dragonmux/HeadphoneAmp/hardware/HeadphoneAmp/HeadphoneAmp.kicad_pcb

## KiCad design hardware/HeadphoneAmp/HeadphoneAmp.kicad_pcb (2022-03-04)

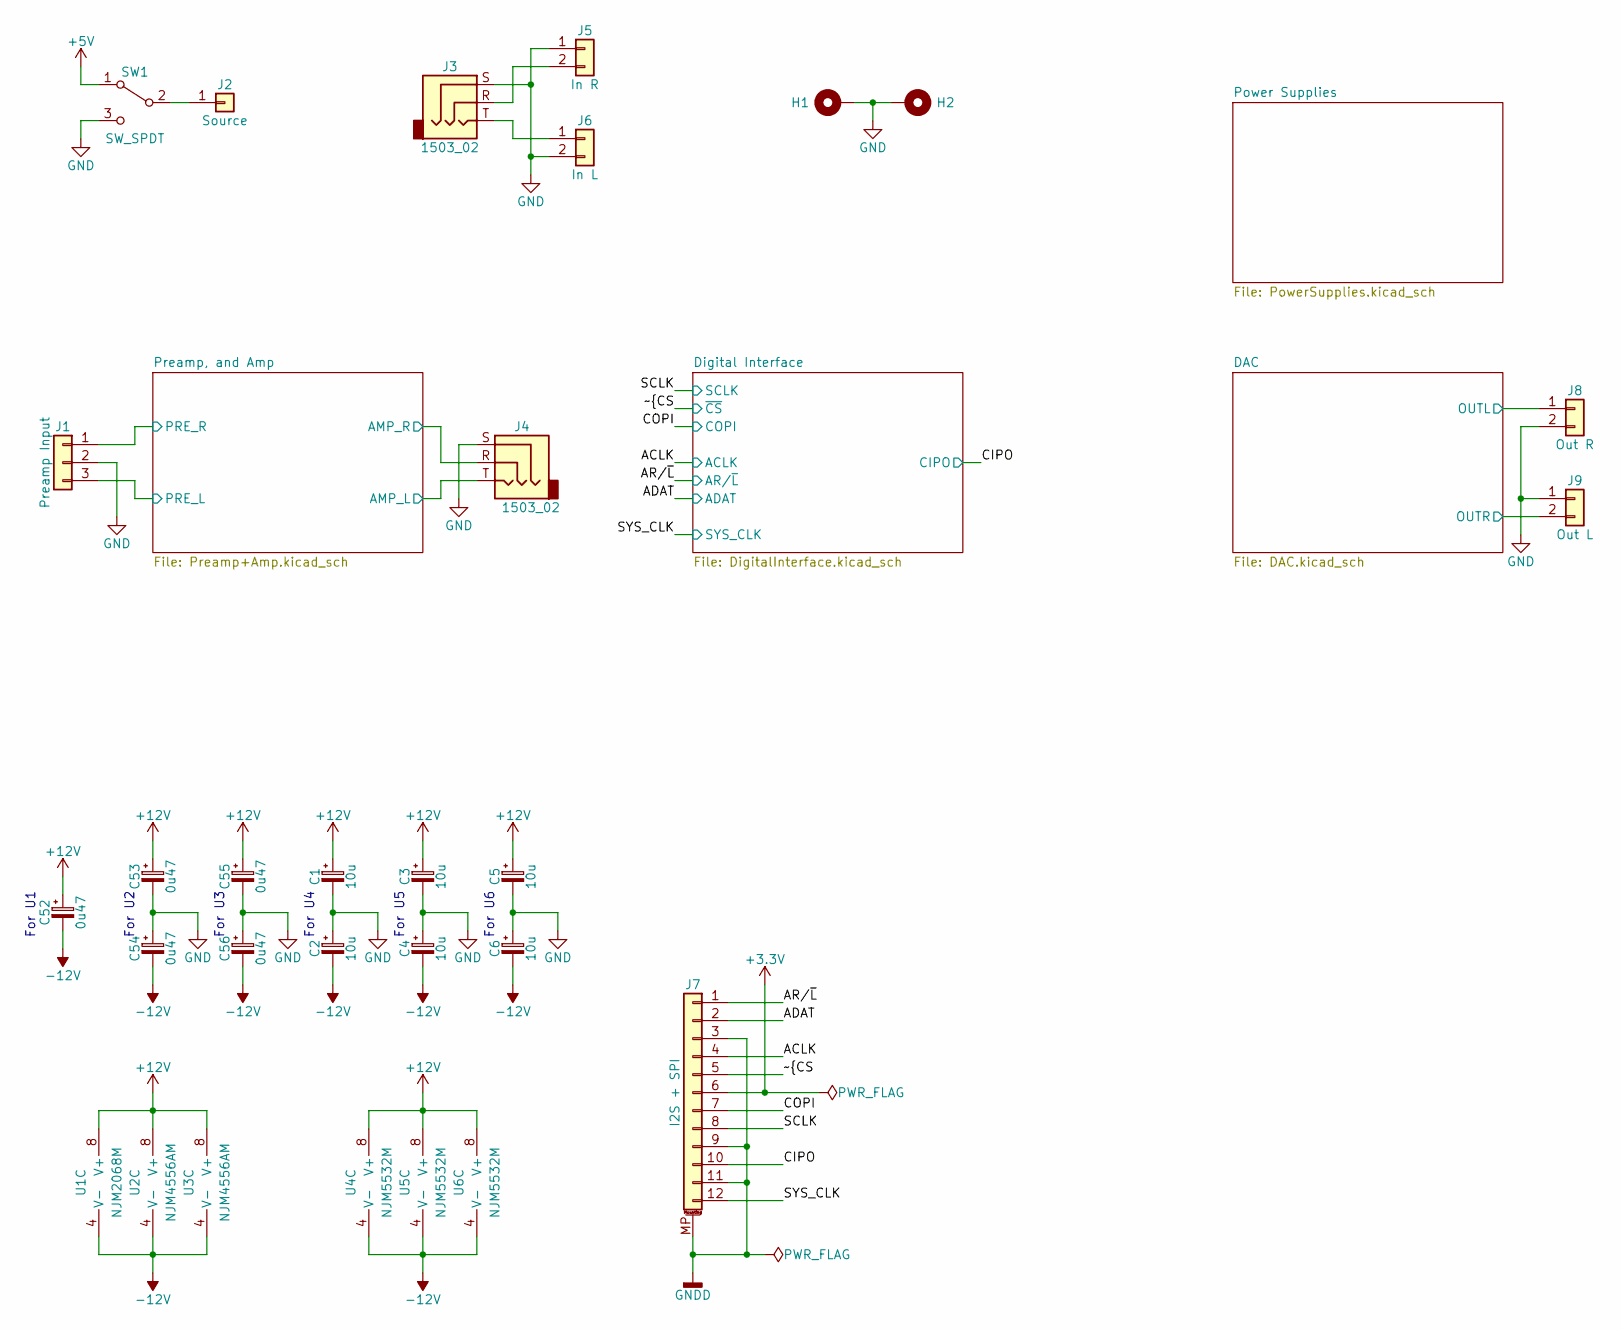
[picture p1: schematic HeadphoneAmp.kicad_sch, Headphone Amplifier + 24-bit -120dBm DAC]

Parts:
C1, C2, C3, C4, C5, C6: 10u; CP_EIA-3216-18_A; MPN 293D106X0016A2TE3
C52, C53, C54, C55, C56: 0u47; CP_EIA-3216-18_A; MPN F931V474KAA
H1, H2: MountingHole_Pad; MountingHole_3.2mm_M3_Pad
J1: Preamp Input; PinHeader_1x03_P2.54mm_Vertical
J2: Source; PinHeader_1x01_P2.54mm_Vertical
J3, J4: 1503_02; 1503-02; MPN 1503 02
J5: In R; PinHeader_1x02_P2.54mm_Vertical
J6: In L; PinHeader_1x02_P2.54mm_Vertical
J7: I2S + SPI; 1-17345952-2_1x12-1MP_P0.5mm_Horizontal; MPN 1-1734592-2
J8: Out R; PinHeader_1x02_P2.54mm_Vertical
J9: Out L; PinHeader_1x02_P2.54mm_Vertical
SW1: SW_SPDT; PN1x-30EQ; MPN PN12SHNA03QE
U1: NJM2068M; SO-8_5.3x5.3mm_P1.27mm; MPN NJM2068M
U2, U3: NJM4556AM; SO-8_5.3x5.3mm_P1.27mm; MPN NJM4556AM
U4, U5, U6: NJM5532M; SO-8_5.3x5.3mm_P1.27mm; MPN NJM5532M

Connections:
+3V3: J7.6; also elsewhere on the board
+5V: SW1.1 (A); also elsewhere on the board
+12V: C1.1, C3.1, C5.1, C52.1, C53.1, C55.1, U1.8 (V+), U2.8 (V+), U3.8 (V+), U4.8 (V+), U5.8 (V+), U6.8 (V+); also elsewhere on the board
-12V: C2.2, C4.2, C6.2, C52.2, C54.2, C56.2, U1.4 (V-), U2.4 (V-), U3.4 (V-), U4.4 (V-), U5.4 (V-), U6.4 (V-); also elsewhere on the board
/ACLK: J7.4; also elsewhere on the board
/ADAT: J7.2; also elsewhere on the board
/AR/~L: J7.1; also elsewhere on the board
/CIPO: J7.10; also elsewhere on the board
/COPI: J7.7; also elsewhere on the board
/DAC/OUTL: J8.1; also elsewhere on the board
/DAC/OUTR: J9.2; also elsewhere on the board
/Preamp, and Amp/AMP_L: J4.T; also elsewhere on the board
/Preamp, and Amp/AMP_R: J4.R; also elsewhere on the board
/Preamp, and Amp/PRE_L: J1.3; also elsewhere on the board
/Preamp, and Amp/PRE_R: J1.1; also elsewhere on the board
/SCLK: J7.8; also elsewhere on the board
/SYS_CLK: J7.12; also elsewhere on the board
/~CS: J7.5; also elsewhere on the board
GND: C1.2, C2.1, C3.2, C4.1, C5.2, C6.1, C53.2, C54.1, C55.2, C56.1, H1.1, H2.1, J1.2, J3.S, J4.S, J5.1, J6.2, J8.2, J9.1, SW1.3 (C); also elsewhere on the board
GNDD: J7.3, J7.9, J7.11, J7.MP (MountPin); also elsewhere on the board
unnamed: J2.1, SW1.2 (B)
unnamed: J3.R, J5.2
unnamed: J3.T, J6.1

Notes on the sheet:
For U4
For U6
For U3
For U1
For U5
For U2

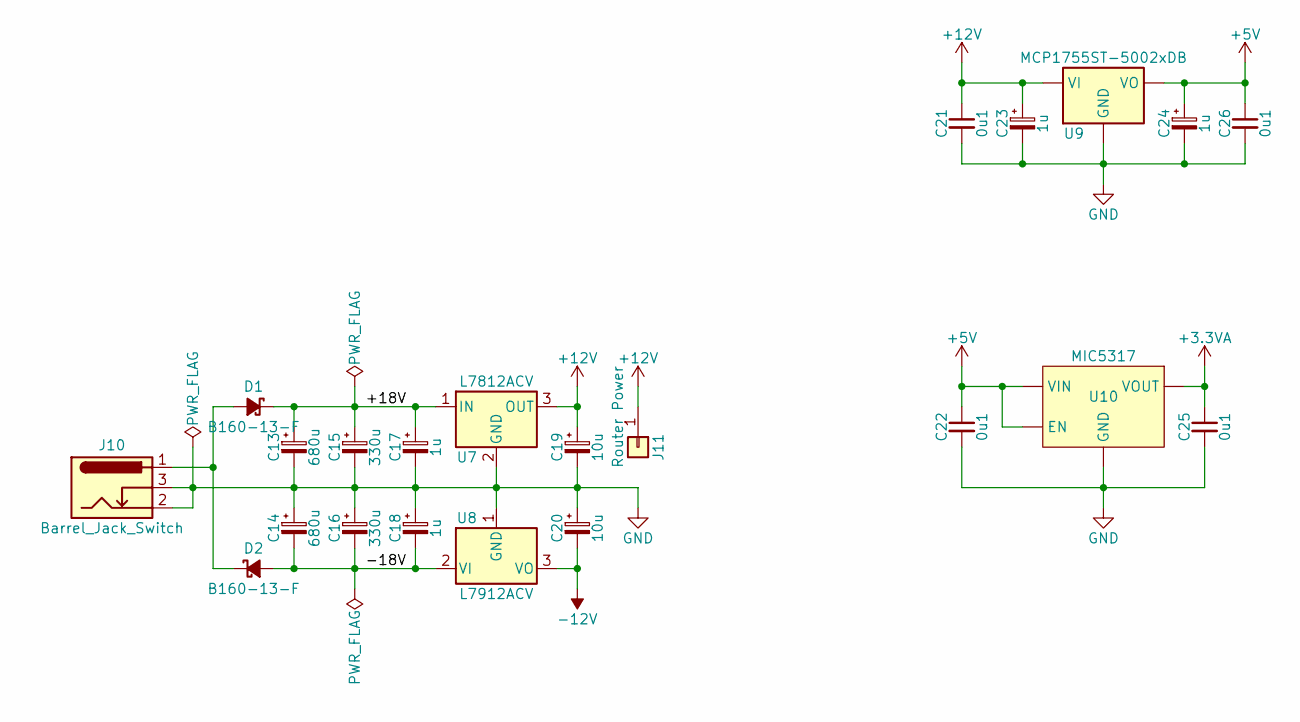
[picture p2: schematic PowerSupplies.kicad_sch, Headphone Amplifier + 24-bit -120dBm DAC]

Parts:
C13, C14: 680u; CP_Radial_D10.0mm_P5.00mm; MPN 25PX680MEFC10X12.5
C15, C16: 330u; CP_Radial_D8.0mm_P3.50mm; MPN 25PX330MEFC8X11.5
C17, C18: 1u; CP_EIA-3216-18_A; MPN 293D105X9025A2TE3
C19, C20: 10u; CP_EIA-3216-18_A; MPN 293D106X0016A2TE3
C21, C22, C26: 0u1; C1210; MPN ECH-U1C104GX5
C23, C24: 1u; CP_EIA-3216-18_A; MPN 293D105X9016A2TE3
C25: 0u1; C0603; MPN CGA3E2X7R1E104K080AA
D1, D2: B160-13-F; D_SMA; MPN B160-13-F
J10: Barrel_Jack_Switch; BarrelJack_GCT_DCJ200-10-A_Horizontal; MPN DCJ200-10-A-K1-K
J11: Router Power; PinHeader_1x01_P2.54mm_Vertical
U7: L7812ACV; TO-220-3_Vertical; MPN L7812ACV
U8: L7912ACV; TO-220-3_Vertical; MPN L7912ACV
U9: MCP1755ST-5002xDB; SOT-223; MPN MCP1755ST-5002E/DB
U10: MIC5317; SOT-23-5; MPN MIC5317-3.3YM5-TR

Connections:
+3.3VA: C25.1, U10.5 (VOUT); also elsewhere on the board
+5V: C22.1, C24.1, C26.1, U9.3 (VO), U10.1 (VIN), U10.3 (EN); also elsewhere on the board
+12V: C19.1, C21.1, C23.1, J11.1, U7.3 (OUT), U9.1 (VI); also elsewhere on the board
-12V: C20.2, U8.3 (VO); also elsewhere on the board
/Power Supplies/+18V: C13.1, C15.1, C17.1, D1.1 (K), U7.1 (IN)
/Power Supplies/-18V: C14.2, C16.2, C18.2, D2.2 (A), U8.2 (VI)
GND: C13.2, C14.1, C15.2, C16.1, C17.2, C18.1, C19.2, C20.1, C21.2, C22.2, C23.2, C24.2, C25.2, C26.2, J10.2, J10.3, U7.2 (GND), U8.1 (GND), U9.2 (GND), U10.2 (GND); also elsewhere on the board
unnamed: D1.2 (A), D2.1 (K), J10.1

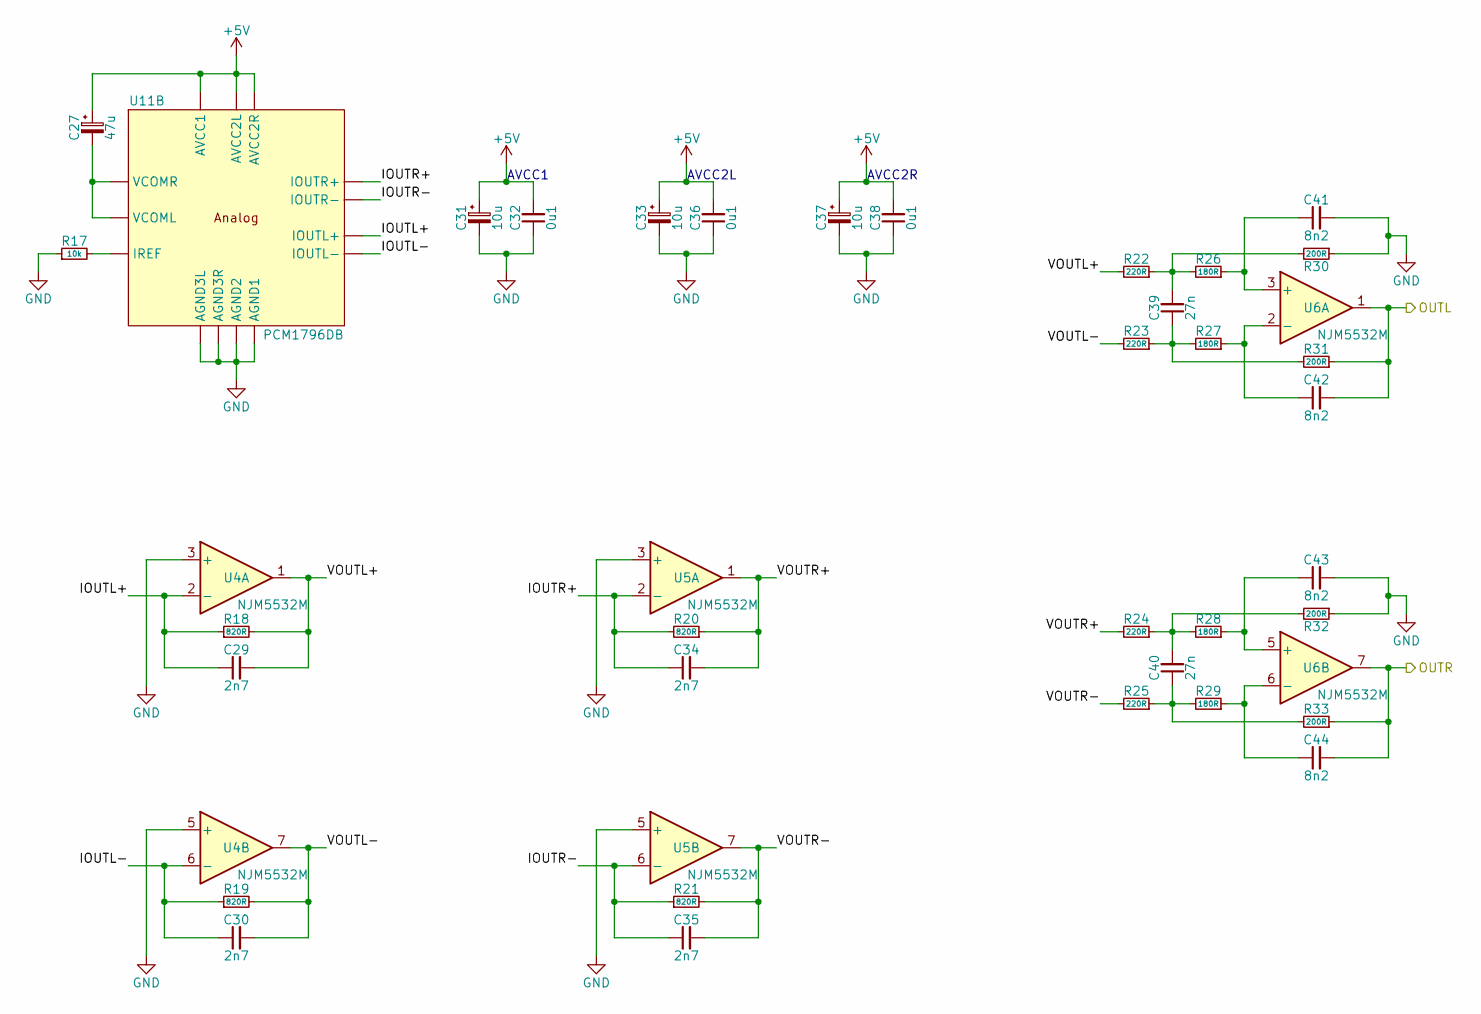
[picture p3: schematic DAC.kicad_sch, Headphone Amplifier + 24-bit -120dBm DAC]

Parts:
C27: 47u; CP_EIA-3528-21_B; MPN 293D476X9010B2TE3
C29, C30, C34, C35: 2n7; C0603; MPN ECH-U1C272GX5
C31, C33, C37: 10u; CP_EIA-3216-18_A; MPN 293D106X0016A2TE3
C32, C36, C38: 0u1; C1210; MPN ECH-U1C104GX5
C39, C40: 27n; C1206; MPN ECH-U1C273GX5
C41, C42, C43, C44: 8n2; C0805; MPN ECH-U1C822GX5
R17: 10k; R0603; MPN RN73H1JTTD1002B25
R18, R19, R20, R21: 820R; R0603; MPN RN73H1JTTD8200F100
R22, R23, R24, R25: 220R; R0603; MPN RN73H1JTTD2200F100
R26, R27, R28, R29: 180R; R0603; MPN RN73H1JTTD1800F100
R30, R31, R32, R33: 200R; R0603; MPN RN73H1JTTD2000B25
U4, U5, U6: NJM5532M; SO-8_5.3x5.3mm_P1.27mm; MPN NJM5532M
U11: PCM1796DB; SSOP-28_5.3x10.2mm_P0.65mm; MPN PCM1796DB

Connections:
+5V: C27.1, C31.1, C32.2, C33.1, C36.2, C37.1, C38.2, U11.15 (AVCC2R), U11.23 (AVCC1), U11.28 (AVCC2L); also elsewhere on the board
/DAC/IOUTL+: C29.1, R18.1, U4.2 (-), U11.25 (IOUTL+)
/DAC/IOUTL-: C30.1, R19.1, U4.6 (-), U11.26 (IOUTL-)
/DAC/IOUTR+: C34.1, R20.2, U5.2 (-), U11.17 (IOUTR+)
/DAC/IOUTR-: C35.1, R21.1, U5.6 (-), U11.18 (IOUTR-)
/DAC/OUTL: C42.2, R31.1, U6.1; also elsewhere on the board
/DAC/OUTR: C44.2, R33.1, U6.7; also elsewhere on the board
/DAC/VOUTL+: C29.2, R18.2, R22.2, U4.1
/DAC/VOUTL-: C30.2, R19.2, R23.2, U4.7
/DAC/VOUTR+: C34.2, R20.1, R24.2, U5.1
/DAC/VOUTR-: C35.2, R21.2, R25.2, U5.7
GND: C31.2, C32.1, C33.2, C36.1, C37.2, C38.1, C41.2, C43.2, R17.1, R30.1, R32.1, U4.3 (+), U4.5 (+), U5.3 (+), U5.5 (+), U11.16 (AGND3R), U11.19 (AGND1), U11.24 (AGND2), U11.27 (AGND3L); also elsewhere on the board
unnamed: C27.2, U11.21 (VCOMR), U11.22 (VCOML)
unnamed: C39.1, R23.1, R27.2, R31.2
unnamed: C39.2, R22.1, R26.2, R30.2
unnamed: C40.1, R25.1, R29.2, R33.2
unnamed: C40.2, R24.1, R28.2, R32.2
unnamed: C41.1, R26.1, U6.3 (+)
unnamed: C42.1, R27.1, U6.2 (-)
unnamed: C43.1, R28.1, U6.5 (+)
unnamed: C44.1, R29.1, U6.6 (-)
unnamed: R17.2, U11.20 (IREF)

Notes on the sheet:
AVCC2R
AVCC1
AVCC2L

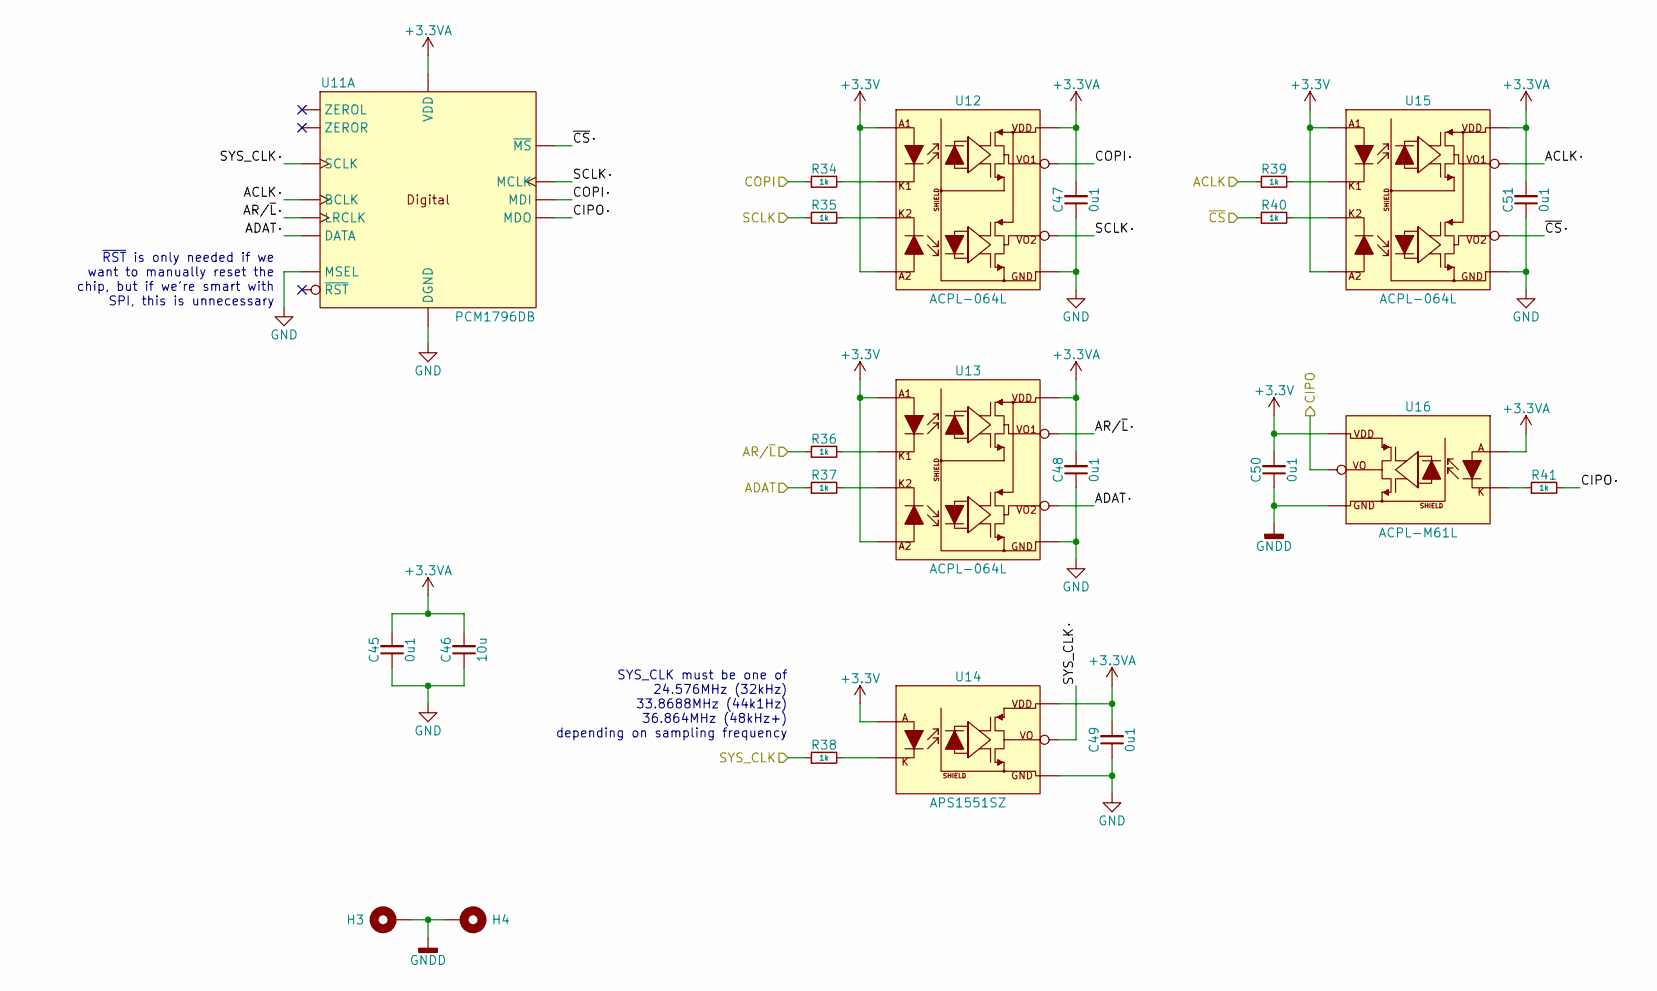
[picture p4: schematic DigitalInterface.kicad_sch]

Parts:
C45, C47, C48, C49, C50, C51: 0u1; C0603; MPN CGA3E2X7R1E104K080AA
C46: 10u; C0805; MPN GRM21BR61E106KA73L
H3, H4: MountingHole_Pad; MountingHole_3.2mm_M3_Pad
R34, R35, R36, R37, R38, R39, R40, R41: 1k; R0603; MPN CRCW06031K00FKEA
U11: PCM1796DB; SSOP-28_5.3x10.2mm_P0.65mm; MPN PCM1796DB
U12, U13, U15: ACPL-064L; SO-8_3.9x4.9mm_P1.27mm; MPN ACPL-064L-500E
U14: APS1551SZ; SO-5_4.4x4.3mm_P1.27mm; MPN APS1551SZ
U16: ACPL-M61L; SO-5_4.4x3.6mm_P1.27mm; MPN ACPL-M61L-5x0E

Connections:
+3.3VA: C45.2, C46.2, C47.2, C48.2, C49.2, C51.2, U11.9 (VDD), U12.8 (VDD), U13.8 (VDD), U14.6 (VDD), U15.8 (VDD), U16.1 (A); also elsewhere on the board
+3V3: C50.2, U12.1 (A1), U12.4 (A2), U13.1 (A1), U13.4 (A2), U14.1 (A), U15.1 (A1), U15.4 (A2), U16.6 (VDD); also elsewhere on the board
/ACLK: R39.1; also elsewhere on the board
/ADAT: R37.1; also elsewhere on the board
/AR/~L: R36.1; also elsewhere on the board
/CIPO: U16.5 (VO); also elsewhere on the board
/COPI: R34.1; also elsewhere on the board
/Digital Interface/ACLK·: U11.6 (BCLK), U15.7 (VO1)
/Digital Interface/ADAT·: U11.5 (DATA), U13.6 (VO2)
/Digital Interface/AR/~L·: U11.4 (LRCLK), U13.7 (VO1)
/Digital Interface/CIPO·: R41.2, U11.13 (MDO)
/Digital Interface/COPI·: U11.11 (MDI), U12.7 (VO1)
/Digital Interface/SCLK·: U11.12 (MCLK), U12.6 (VO2)
/Digital Interface/SYS_CLK·: U11.7 (SCLK), U14.5 (VO)
/Digital Interface/~CS·: U11.10 (~MS), U15.6 (VO2)
/SCLK: R35.1; also elsewhere on the board
/SYS_CLK: R38.1; also elsewhere on the board
/~CS: R40.1; also elsewhere on the board
GND: C45.1, C46.1, C47.1, C48.1, C49.1, C51.1, U11.3 (MSEL), U11.8 (DGND), U12.5 (GND), U13.5 (GND), U14.4 (GND), U15.5 (GND); also elsewhere on the board
GNDD: C50.1, H3.1, H4.1, U16.4 (GND); also elsewhere on the board
unnamed: R34.2, U12.2 (K1)
unnamed: R35.2, U12.3 (K2)
unnamed: R36.2, U13.2 (K1)
unnamed: R37.2, U13.3 (K2)
unnamed: R38.2, U14.3 (K)
unnamed: R39.2, U15.2 (K1)
unnamed: R40.2, U15.3 (K2)
unnamed: R41.1, U16.3 (K)

Notes on the sheet:
SYS_CLK must be one of 24.576MHz (32kHz) 33.8688MHz (44k1Hz) 36.864MHz (48kHz+) depending on sampling frequency
~{RST} is only needed if we want to manually reset the chip, but if we're smart with SPI, this is unnecessary

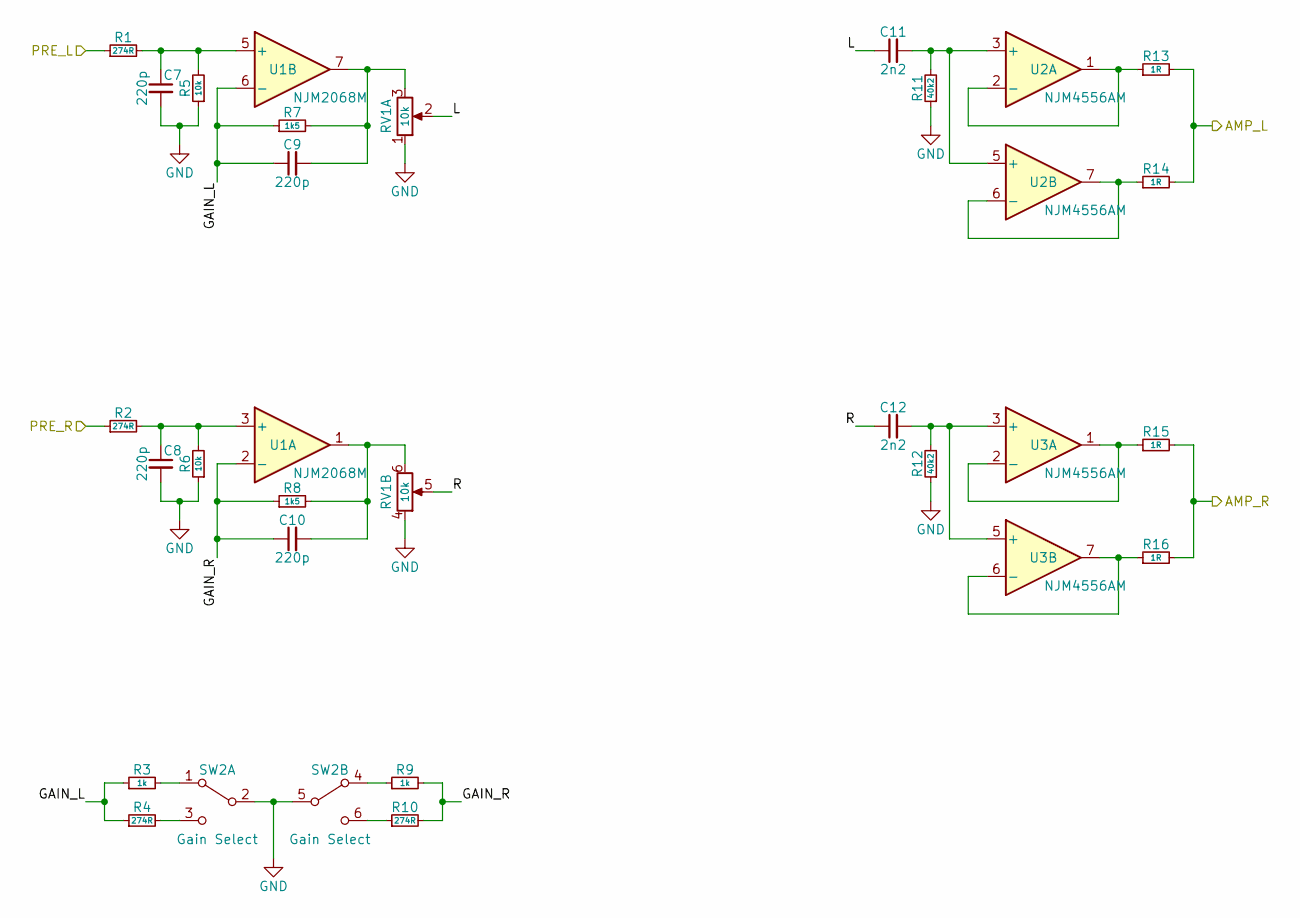
[picture p5: schematic Preamp+Amp.kicad_sch, Headphone Amplifier + 24-bit -120dBm DAC]

Parts:
C7, C8, C9, C10: 220p; C0603; MPN ECH-U1C221GX5
C11, C12: 2n2; C0603; MPN ECH-U1C222GX5
R1, R2, R4, R10: 274R; R0603; MPN RN731JTTD2740B25
R3, R9: 1k; R0603; MPN RN73H1JTTD1001D25
R5, R6: 10k; R0603; MPN RN73H1JTTD1002B25
R7, R8: 1k5; R0603; MPN RN73H1JTTD1501B25
R11, R12: 40k2; R0603; MPN RN73H1ETTP4022F25
R13, R14, R15, R16: 1R; R1206; MPN MCA12060C1008FP500
RV1: 10k; PTD902; MPN PTD902-2015F-A103
SW2: Gain Select; PN2x-30EQ; MPN PN22LENA03QE
U1: NJM2068M; SO-8_5.3x5.3mm_P1.27mm; MPN NJM2068M
U2, U3: NJM4556AM; SO-8_5.3x5.3mm_P1.27mm; MPN NJM4556AM

Connections:
/Preamp, and Amp/AMP_L: R13.2, R14.2; also elsewhere on the board
/Preamp, and Amp/AMP_R: R15.2, R16.2; also elsewhere on the board
/Preamp, and Amp/GAIN_L: C9.1, R3.1, R4.1, R7.1, U1.6 (-)
/Preamp, and Amp/GAIN_R: C10.1, R8.1, R9.2, R10.2, U1.2 (-)
/Preamp, and Amp/L: C11.1, RV1.2
/Preamp, and Amp/PRE_L: R1.1; also elsewhere on the board
/Preamp, and Amp/PRE_R: R2.1; also elsewhere on the board
/Preamp, and Amp/R: C12.1, RV1.5
GND: C7.2, C8.2, R5.1, R6.1, R11.1, R12.1, RV1.1, RV1.4, SW2.2 (B), SW2.5 (B); also elsewhere on the board
unnamed: C7.1, R1.2, R5.2, U1.5 (+)
unnamed: C8.1, R2.2, R6.2, U1.3 (+)
unnamed: C9.2, R7.2, RV1.3, U1.7
unnamed: C10.2, R8.2, RV1.6, U1.1
unnamed: C11.2, R11.2, U2.3 (+), U2.5 (+)
unnamed: C12.2, R12.2, U3.3 (+), U3.5 (+)
unnamed: R3.2, SW2.1 (A)
unnamed: R4.2, SW2.3 (C)
unnamed: R9.1, SW2.4 (A)
unnamed: R10.1, SW2.6 (C)
unnamed: R13.1, U2.1, U2.2 (-)
unnamed: R14.1, U2.6 (-), U2.7
unnamed: R15.1, U3.1, U3.2 (-)
unnamed: R16.1, U3.6 (-), U3.7

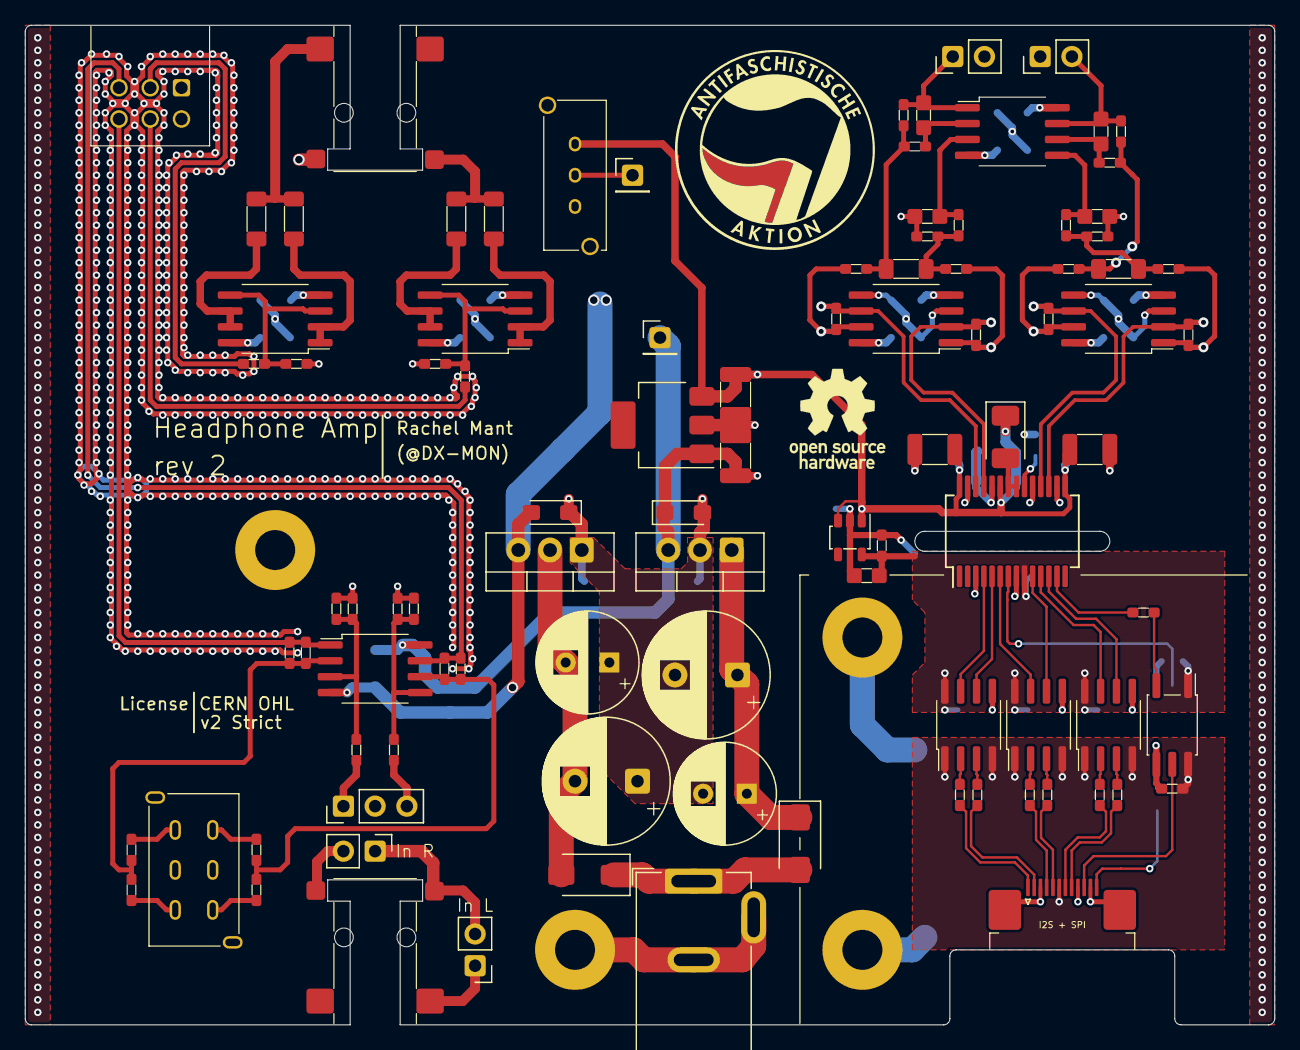
[picture p6: board HeadphoneAmp.kicad_pcb from above]

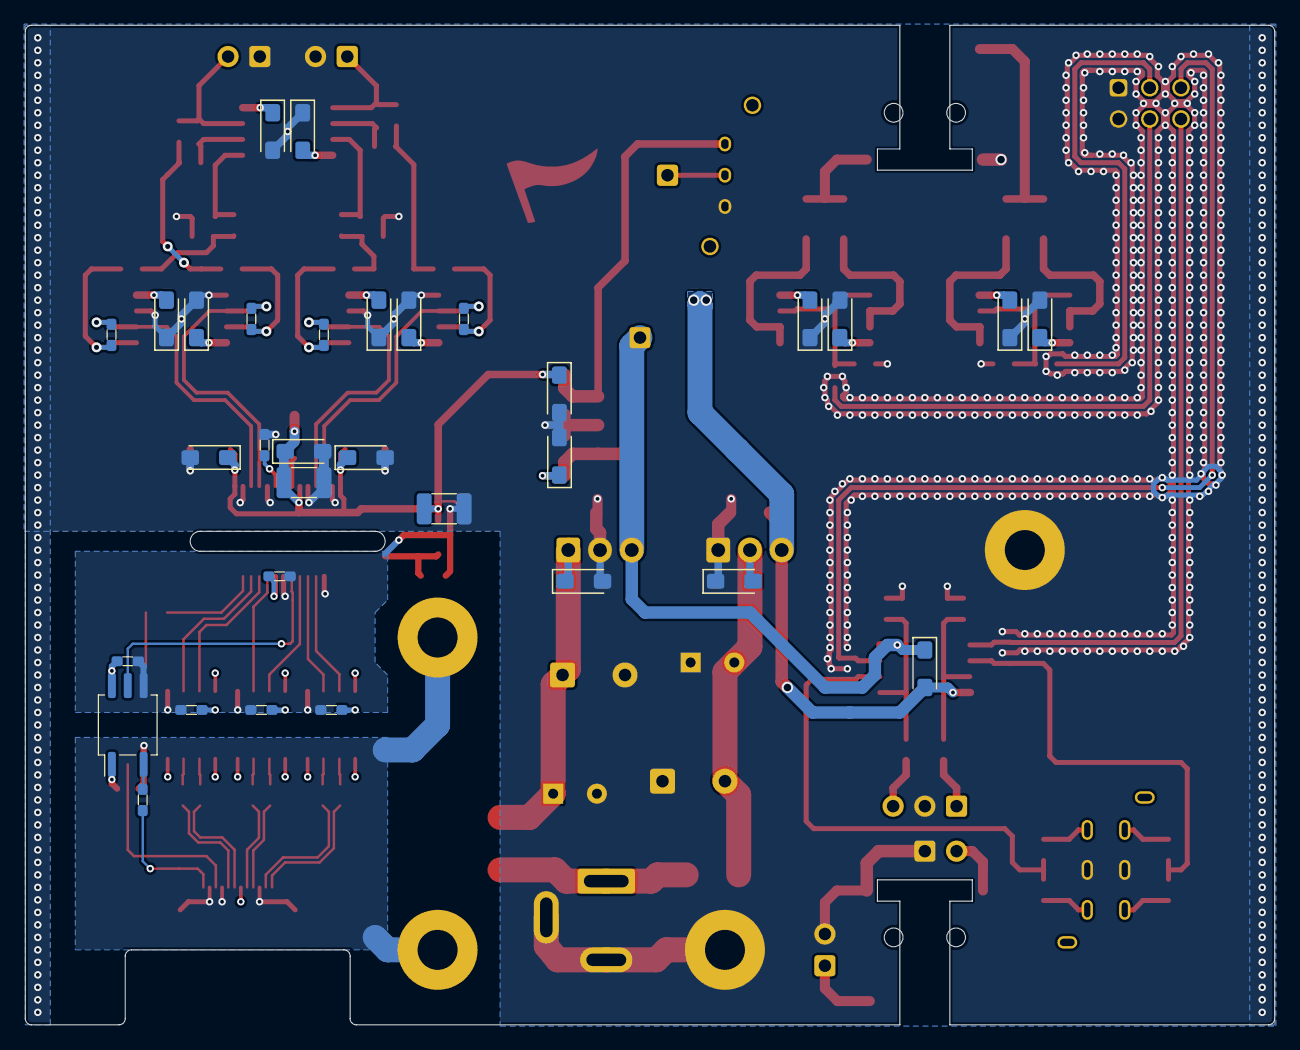
[picture p7: board HeadphoneAmp.kicad_pcb from below]

Board: 4 copper layers, 100.0 x 80.0 mm, 134 parts (32 on the bottom side), 79 nets.

Other parts of the board:
G1: ANTIFA; Antifaschistische-Aktion_Inv_600dpi
G2: OSHW-Logo_7.5x8mm_SilkScreen
