dragonmux/HeadphoneAmp/hardware/AudioInterface/AudioInterface.kicad_pcb

## KiCad design hardware/AudioInterface/AudioInterface.kicad_pcb (2022-03-04)

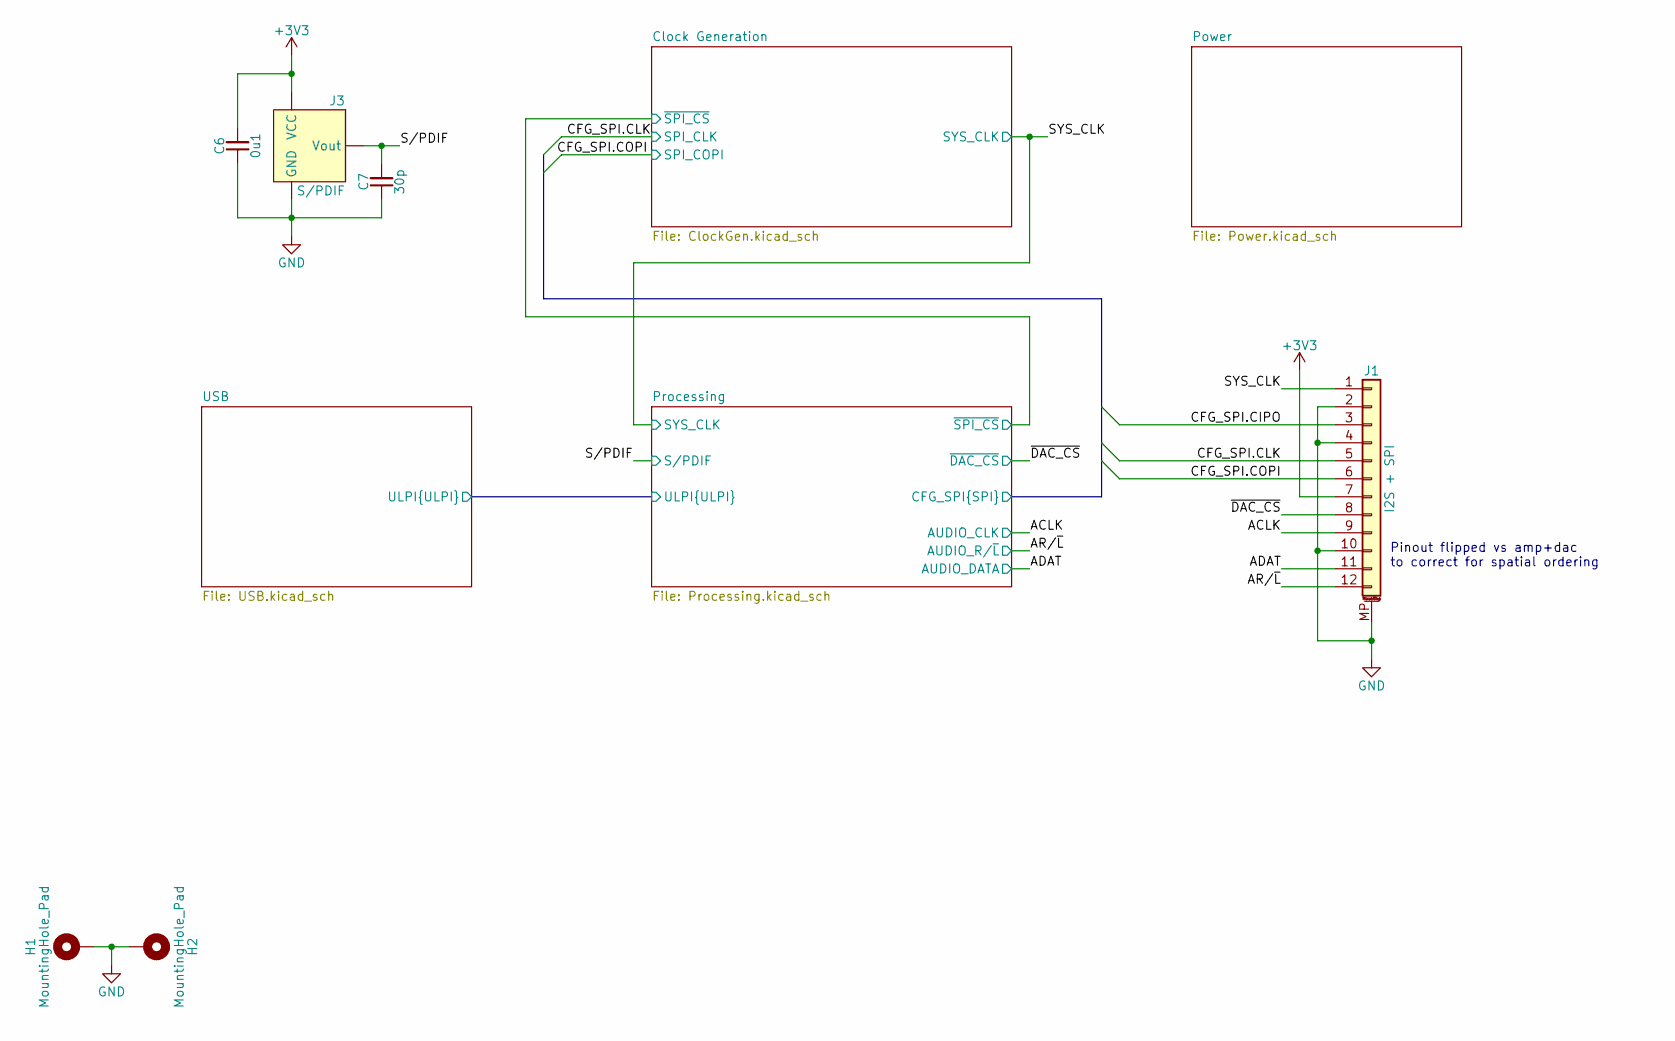
[picture p8: schematic AudioInterface.kicad_sch]

Parts:
C6: 0u1; C0603; MPN CGA3E2X7R1E104K080AA
C7: 30p; C0603; MPN CC0603FRNPO9BN300
H1, H2: MountingHole_Pad; MountingHole_3.2mm_M3_Pad
J1: I2S + SPI; 1-17345952-2_1x12-1MP_P0.5mm_Horizontal; MPN 1-1734592-2
J3: S/PDIF; S-PDIF_Receiver; MPN FCR684208R

Connections:
+3V3: C6.2, J1.7, J3.3 (VCC); also elsewhere on the board
/ACLK: J1.9; also elsewhere on the board
/ADAT: J1.11; also elsewhere on the board
/AR/~L: J1.12; also elsewhere on the board
/Processing/CFG_SPI.CIPO: J1.3; also elsewhere on the board
/Processing/CFG_SPI.CLK: J1.5; also elsewhere on the board
/Processing/CFG_SPI.COPI: J1.6; also elsewhere on the board
/SYS_CLK: J1.1; also elsewhere on the board
/S/PDIF: C7.2, J3.1 (Vout); also elsewhere on the board
/~DAC_CS: J1.8; also elsewhere on the board
DGND: C6.1, C7.1, H1.1, H2.1, J1.2, J1.4, J1.10, J1.MP (MountPin), J3.2 (GND); also elsewhere on the board

Notes on the sheet:
Pinout flipped vs amp+dac to correct for spatial ordering

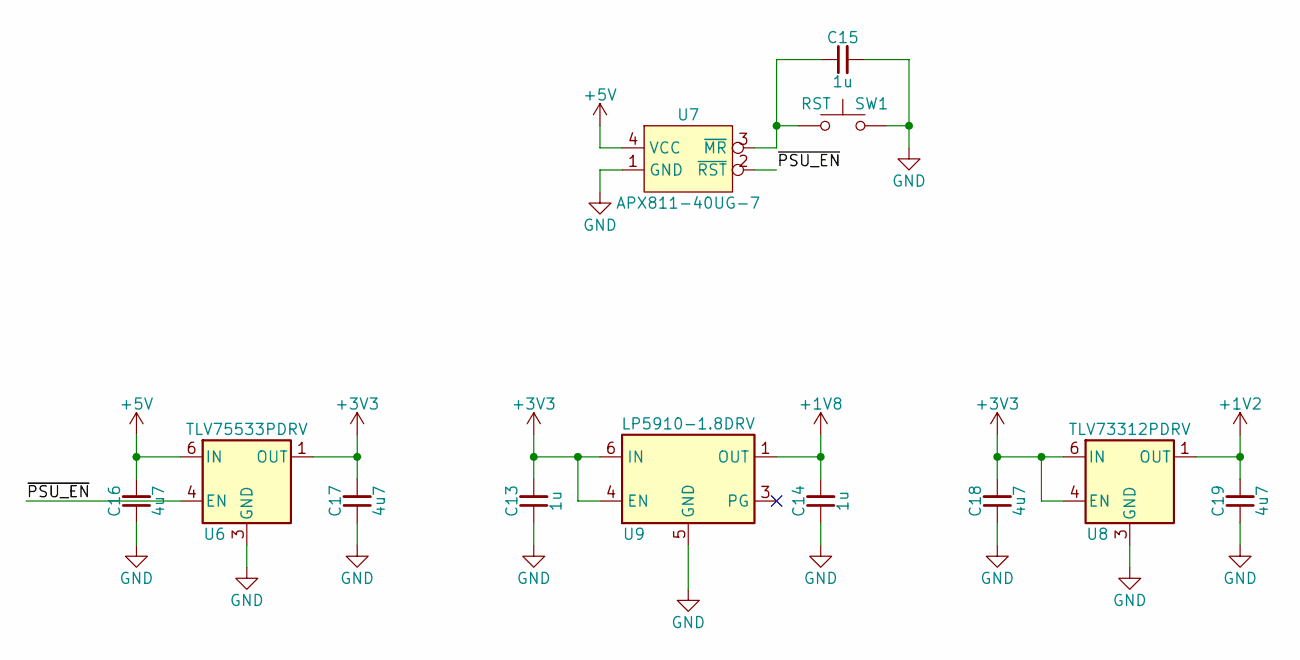
[picture p9: schematic Power.kicad_sch]

Parts:
C13, C14, C15: 1u; C0603; MPN C0603C105K4RAC7867
C16, C17, C18, C19: 4u7; C0603; MPN C1608X5R1C475K080AC
SW1: RST; B3U-1000P-B; MPN B3U-1000P-B
U6: TLV75533PDRV; WSON-6-1EP_2x2mm_P0.65mm_EP1x1.6mm; MPN TLV75533PDRVR
U7: APX811-40UG-7; SOT-143; MPN APX811-40UG-7
U8: TLV73312PDRV; WSON-6-1EP_2x2mm_P0.65mm_EP1x1.6mm; MPN TLV73312PQDRVRQ1
U9: LP5910-1.8DRV; WSON-6-1EP_2x2mm_P0.65mm_EP1x1.6mm; MPN LP5910-1.8DRVR

Connections:
+1V2: C19.2, U8.1 (OUT); also elsewhere on the board
+1V8: C14.2, U9.1 (OUT); also elsewhere on the board
+3V3: C13.2, C17.2, C18.2, U6.1 (OUT), U8.4 (EN), U8.6 (IN), U9.4 (EN), U9.6 (IN); also elsewhere on the board
+5V: C16.2, U6.6 (IN), U7.4 (VCC); also elsewhere on the board
/Power/~PSU_EN: U6.4 (EN), U7.2 (~RST)
DGND: C13.1, C14.1, C15.2, C16.1, C17.1, C18.1, C19.1, SW1.2, U6.2 (NC), U6.3 (GND), U6.5 (NC), U6.7 (GND), U7.1 (GND), U8.2 (NC), U8.3 (GND), U8.5 (NC), U8.7 (GND), U9.2 (NC), U9.5 (GND), U9.7 (EP); also elsewhere on the board
unnamed: C15.1, SW1.1, U7.3 (~MR)

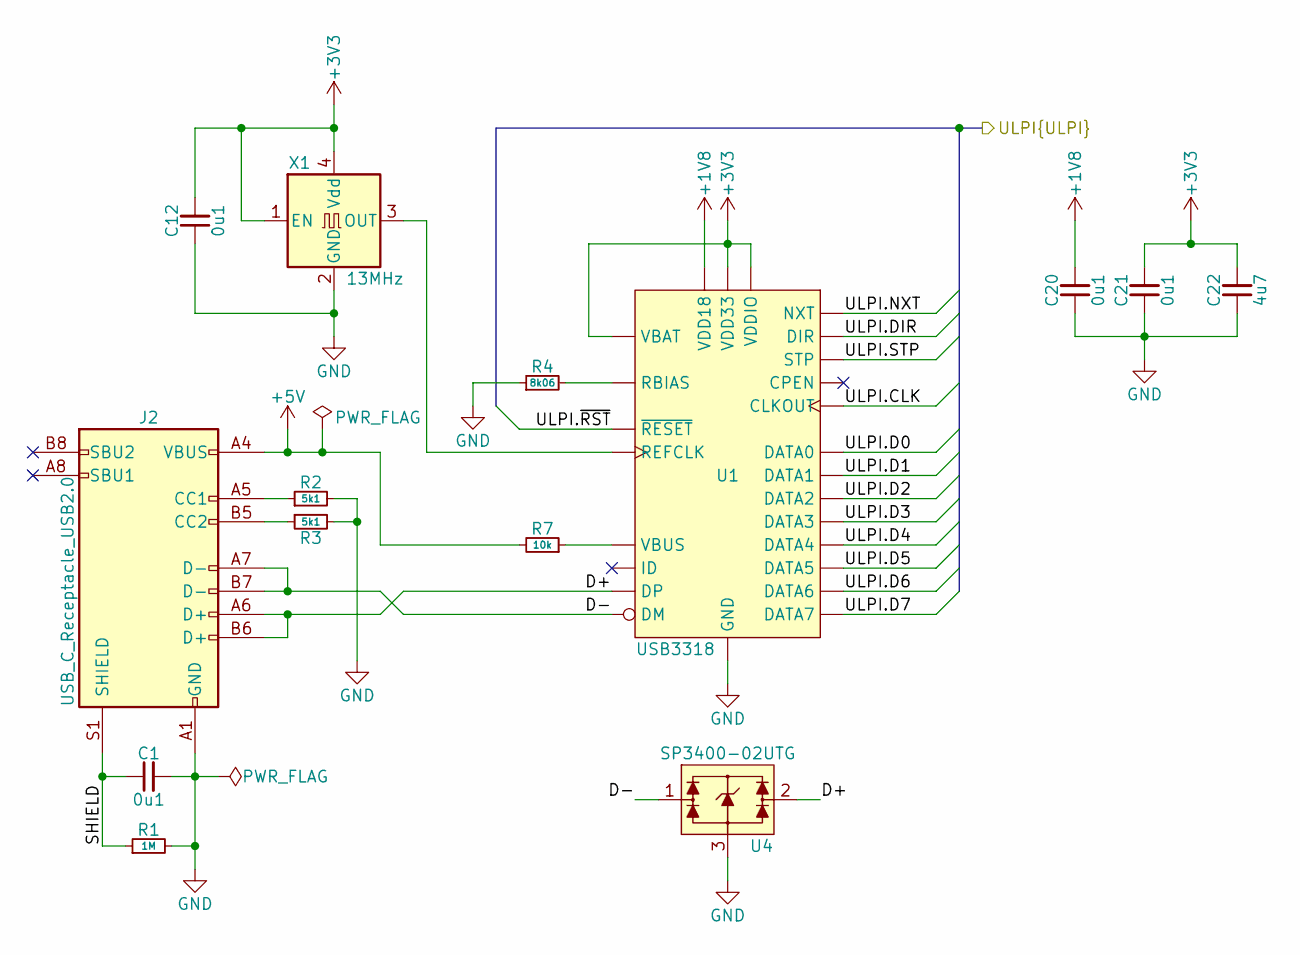
[picture p10: schematic USB.kicad_sch]

Parts:
C1, C12, C20, C21: 0u1; C0603; MPN CGA3E2X7R1E104K080AA
C22: 4u7; C0603; MPN C1608X5R1C475K080AC
J2: USB_C_Receptacle_USB2.0; USB_C_Receptacle_HRO_TYPE-C-31-M-12; MPN TYPE-C-31-M-12
R1: 1M; R0603; MPN CRCW06031M00FKEA
R2, R3: 5k1; R0603; MPN CRCW06035K10FKEA
R4: 8k06; R0603; MPN CRCW06038K06FKEA
R7: 10k; R0603; MPN CRCW060310K0FKEA
U1: USB3318; QFN-24-1EP_4x4mm_P0.5mm_EP2.6x2.6mm; MPN USB3318-CP-TR
U4: SP3400-02UTG; UDFN-6L; MPN SP3400-02UTG
X1: 13MHz; SMD2520; MPN 8W-13.000MBE-T

Connections:
+1V8: C20.2, U1.21 (VDD18); also elsewhere on the board
+3V3: C12.2, C21.2, C22.2, U1.3 (VBAT), U1.4 (VDD33), U1.17 (VDDIO), X1.1 (EN), X1.4 (Vdd); also elsewhere on the board
+5V: J2.A4 (VBUS), J2.A9 (VBUS), J2.B4 (VBUS), J2.B9 (VBUS), R7.2; also elsewhere on the board
/Processing/ULPI.CLK: U1.12 (CLKOUT); also elsewhere on the board
/Processing/ULPI.D0: U1.16 (DATA0); also elsewhere on the board
/Processing/ULPI.D1: U1.15 (DATA1); also elsewhere on the board
/Processing/ULPI.D2: U1.14 (DATA2); also elsewhere on the board
/Processing/ULPI.D3: U1.13 (DATA3); also elsewhere on the board
/Processing/ULPI.D4: U1.11 (DATA4); also elsewhere on the board
/Processing/ULPI.D5: U1.10 (DATA5); also elsewhere on the board
/Processing/ULPI.D6: U1.9 (DATA6); also elsewhere on the board
/Processing/ULPI.D7: U1.8 (DATA7); also elsewhere on the board
/Processing/ULPI.DIR: U1.19 (DIR); also elsewhere on the board
/Processing/ULPI.NXT: U1.18 (NXT); also elsewhere on the board
/Processing/ULPI.STP: U1.20 (STP); also elsewhere on the board
/Processing/ULPI.~RST: U1.22 (~RESET); also elsewhere on the board
/USB/D+: J2.A6 (D+), J2.B6 (D+), U1.6 (DP), U4.2 (IO2), U4.5 (NC)
/USB/D-: J2.A7 (D-), J2.B7 (D-), U1.5 (DM), U4.1 (IO1), U4.6 (NC)
/USB/SHIELD: C1.1, J2.S1 (SHIELD), R1.1
DGND: C1.2, C12.1, C20.1, C21.1, C22.1, J2.A1 (GND), J2.A12 (GND), J2.B1 (GND), J2.B12 (GND), R1.2, R2.2, R3.2, R4.1, U1.25 (GND), U4.3 (GND), U4.4 (GND), X1.2 (GND); also elsewhere on the board
unnamed: J2.A5 (CC1), R2.1
unnamed: J2.B5 (CC2), R3.1
unnamed: R4.2, U1.24 (RBIAS)
unnamed: R7.1, U1.2 (VBUS)
unnamed: U1.23 (REFCLK), X1.3 (OUT)
