dragonmux/HeadphoneAmp/hardware/AudioInterface/AudioInterface.kicad_pcb

## KiCad design hardware/AudioInterface/AudioInterface.kicad_pcb (continued)

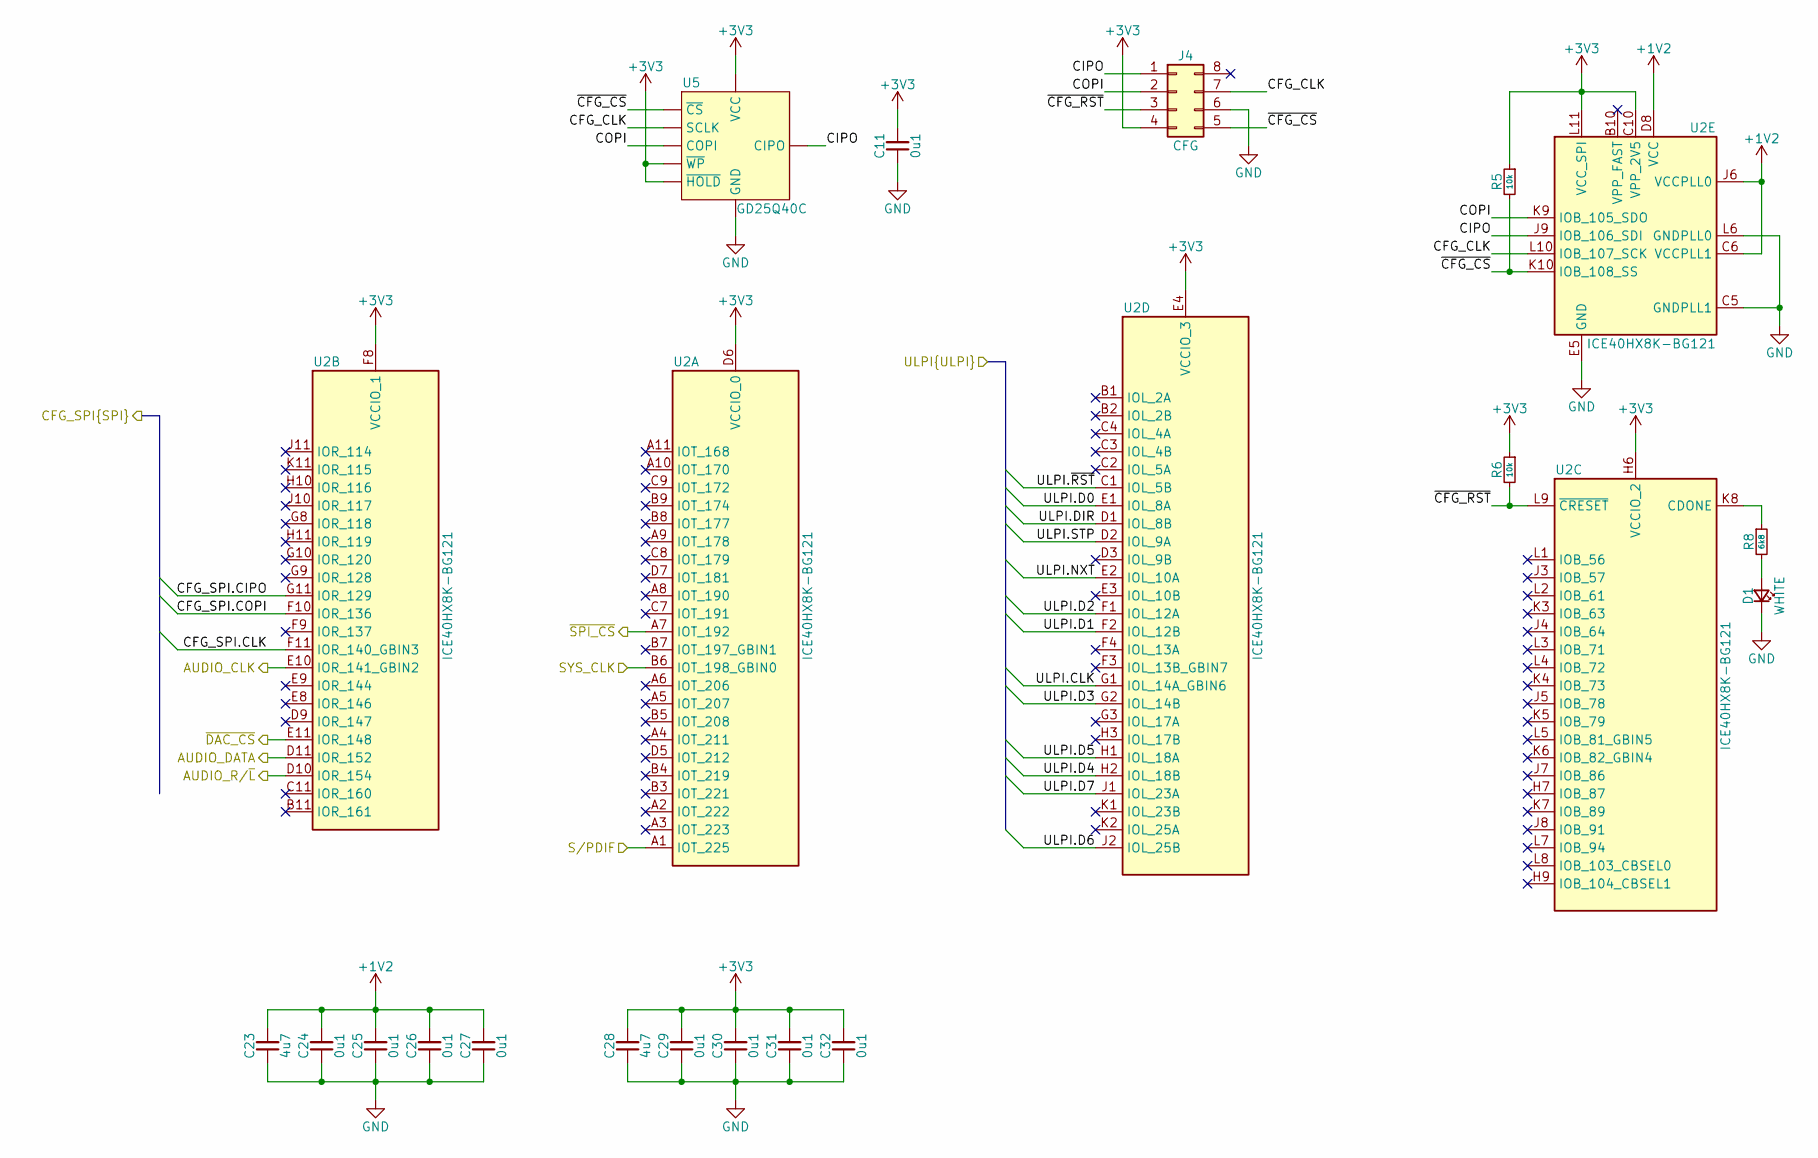
[picture p11: schematic Processing.kicad_sch]

Parts:
C11: 0u1; C0603; MPN CGA3E2X7R1E104K080AA
C23, C28: 4u7; C0603; MPN C1608X5R1C475K080AC
C24, C25, C26, C27, C29, C30, C31, C32: 0u1; C0402; MPN CC0402KRX7R7BB104
D1: WHITE; LED0603; MPN ORH-W46G
J4: CFG; PinHeader_2x04_P1.27mm_Vertical_SMD; MPN FTSH-104-01-L-DV
R5, R6: 10k; R0603; MPN CRCW060310K0FKEA
R8: 6k8; R0603; MPN CRCW06036K80FKEA
U2: ICE40HX8K-BG121; BGA-121_9.0x9.0mm_Layout11x11_P0.8mm_Ball0.4mm_Pad0.35mm_NS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; MPN ICE40HX8K-BG121
U5: GD25Q40C; UDFN-8-1EP_3x2mm_P0.5mm_EP1.4x1.4mm; MPN GD25Q40CEIGR

Connections:
+1V2: C23.2, C24.2, C25.2, C26.2, C27.2, U2.C6 (VCCPLL1), U2.D4 (VCC), U2.D8 (VCC), U2.H4 (VCC), U2.H8 (VCC), U2.J6 (VCCPLL0); also elsewhere on the board
+3V3: C11.2, C28.2, C29.2, C30.2, C31.2, C32.2, J4.4, R5.1, R6.1, U2.C10 (VPP_2V5), U2.D6 (VCCIO_0), U2.E4 (VCCIO_3), U2.F8 (VCCIO_1), U2.G4 (VCCIO_3), U2.H6 (VCCIO_2), U2.L11 (VCC_SPI), U5.3 (~WP), U5.7 (~HOLD), U5.8 (VCC); also elsewhere on the board
/ACLK: U2.E10 (IOR_141_GBIN2); also elsewhere on the board
/ADAT: U2.D11 (IOR_152); also elsewhere on the board
/AR/~L: U2.D10 (IOR_154); also elsewhere on the board
/Clock Generation/~SPI_CS: U2.A7 (IOT_192); also elsewhere on the board
/Processing/CFG_CLK: J4.7, U2.L10 (IOB_107_SCK), U5.6 (SCLK)
/Processing/CFG_SPI.CIPO: U2.G11 (IOR_129); also elsewhere on the board
/Processing/CFG_SPI.CLK: U2.F11 (IOR_140_GBIN3); also elsewhere on the board
/Processing/CFG_SPI.COPI: U2.F10 (IOR_136); also elsewhere on the board
/Processing/CIPO: J4.1, U2.J9 (IOB_106_SDI), U5.2 (CIPO)
/Processing/COPI: J4.2, U2.K9 (IOB_105_SDO), U5.5 (COPI)
/Processing/ULPI.CLK: U2.G1 (IOL_14A_GBIN6); also elsewhere on the board
/Processing/ULPI.D0: U2.E1 (IOL_8A); also elsewhere on the board
/Processing/ULPI.D1: U2.F2 (IOL_12B); also elsewhere on the board
/Processing/ULPI.D2: U2.F1 (IOL_12A); also elsewhere on the board
/Processing/ULPI.D3: U2.G2 (IOL_14B); also elsewhere on the board
/Processing/ULPI.D4: U2.H2 (IOL_18B); also elsewhere on the board
/Processing/ULPI.D5: U2.H1 (IOL_18A); also elsewhere on the board
/Processing/ULPI.D6: U2.J2 (IOL_25B); also elsewhere on the board
/Processing/ULPI.D7: U2.J1 (IOL_23A); also elsewhere on the board
/Processing/ULPI.DIR: U2.D1 (IOL_8B); also elsewhere on the board
/Processing/ULPI.NXT: U2.E2 (IOL_10A); also elsewhere on the board
/Processing/ULPI.STP: U2.D2 (IOL_9A); also elsewhere on the board
/Processing/ULPI.~RST: U2.C1 (IOL_5B); also elsewhere on the board
/Processing/~CFG_CS: J4.5, R5.2, U2.K10 (IOB_108_SS), U5.1 (~CS)
/Processing/~CFG_RST: J4.3, R6.2, U2.L9 (~CRESET)
/SYS_CLK: U2.B6 (IOT_198_GBIN0); also elsewhere on the board
/S/PDIF: U2.A1 (IOT_225); also elsewhere on the board
/~DAC_CS: U2.E11 (IOR_148); also elsewhere on the board
DGND: C11.1, C23.1, C24.1, C25.1, C26.1, C27.1, C28.1, C29.1, C30.1, C31.1, C32.1, D1.1 (K), J4.6, U2.C5 (GNDPLL1), U2.E5 (GND), U2.E6 (GND), U2.E7 (GND), U2.F5 (GND), U2.F6 (GND), U2.F7 (GND), U2.G5 (GND), U2.G6 (GND), U2.G7 (GND), U2.H5 (GND), U2.L6 (GNDPLL0), U5.4 (GND), U5.9 (GND); also elsewhere on the board
unnamed: D1.2 (A), R8.2
unnamed: R8.1, U2.K8 (CDONE)

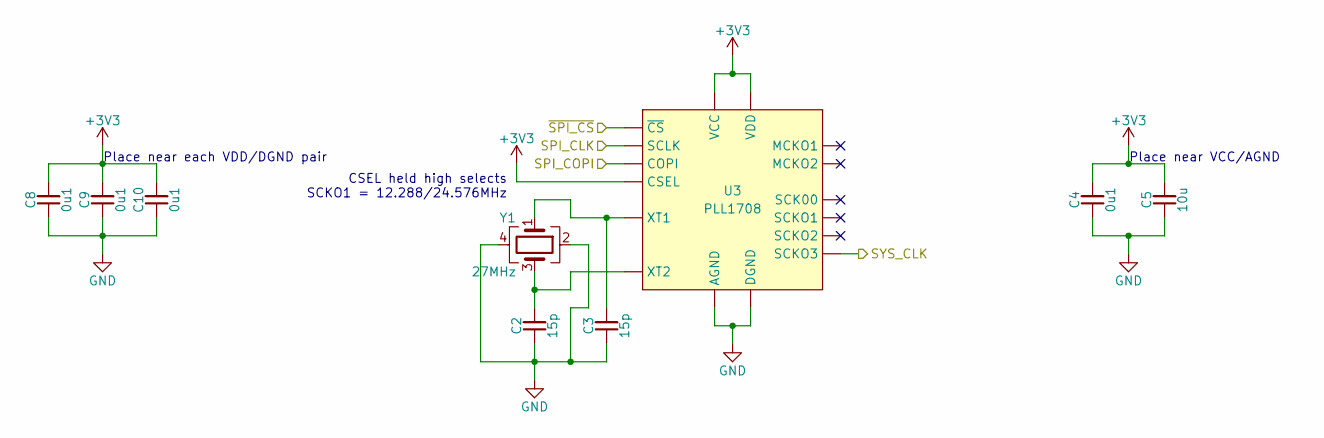
[picture p12: schematic ClockGen.kicad_sch]

Parts:
C2, C3: 15p; C0603; MPN 06035A150JAT4A
C4, C8, C9, C10: 0u1; C0603; MPN CGA3E2X7R1E104K080AA
C5: 10u; C0603; MPN GRM188R61E106KA73D
U3: PLL1708; SSOP-20_3.9x8.7mm_P0.635mm; MPN PLL1708DBQ
Y1: 27MHz; SMD3225; MPN 7V-27.000MDDQ-T

Connections:
+3V3: C4.2, C5.2, C8.2, C9.2, C10.2, U3.1 (VDD), U3.8 (VCC), U3.12 (CSEL), U3.13 (VDD), U3.20 (VDD); also elsewhere on the board
/Clock Generation/~SPI_CS: U3.7 (~CS); also elsewhere on the board
/Processing/CFG_SPI.CLK: U3.6 (SCLK); also elsewhere on the board
/Processing/CFG_SPI.COPI: U3.5 (COPI); also elsewhere on the board
/SYS_CLK: U3.3 (SCKO3); also elsewhere on the board
DGND: C2.1, C3.1, C4.1, C5.1, C8.1, C9.1, C10.1, U3.4 (DGND), U3.9 (AGND), U3.16 (DGND), U3.17 (DGND), Y1.2, Y1.4; also elsewhere on the board
unnamed: C2.2, U3.11 (XT2), Y1.3
unnamed: C3.2, U3.10 (XT1), Y1.1

Notes on the sheet:
CSEL held high selects SCKO1 = 12.288/24.576MHz
Place near VCC/AGND
Place near each VDD/DGND pair

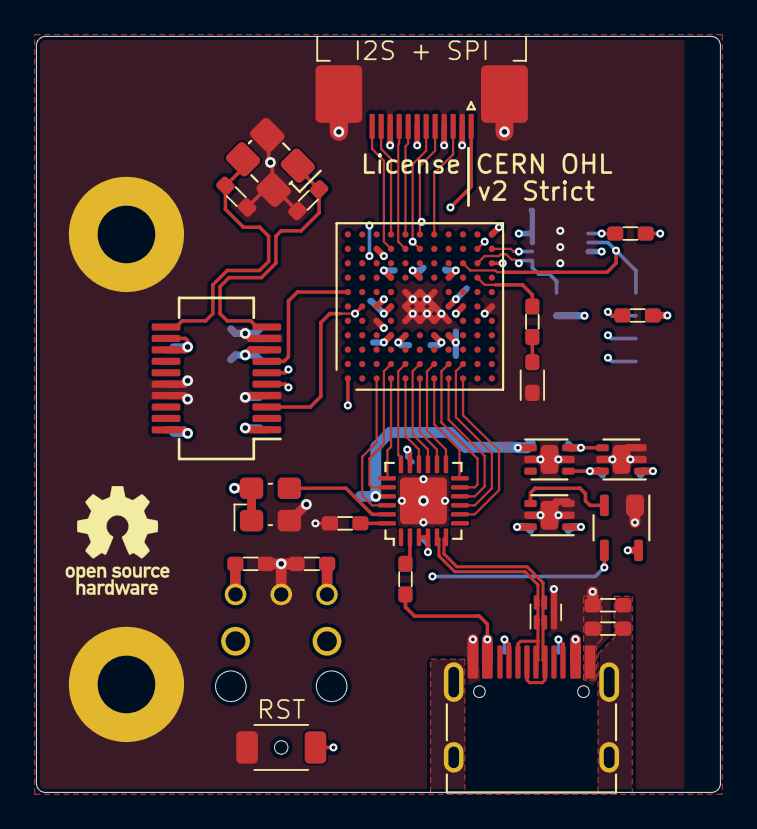
[picture p13: board AudioInterface.kicad_pcb from above]

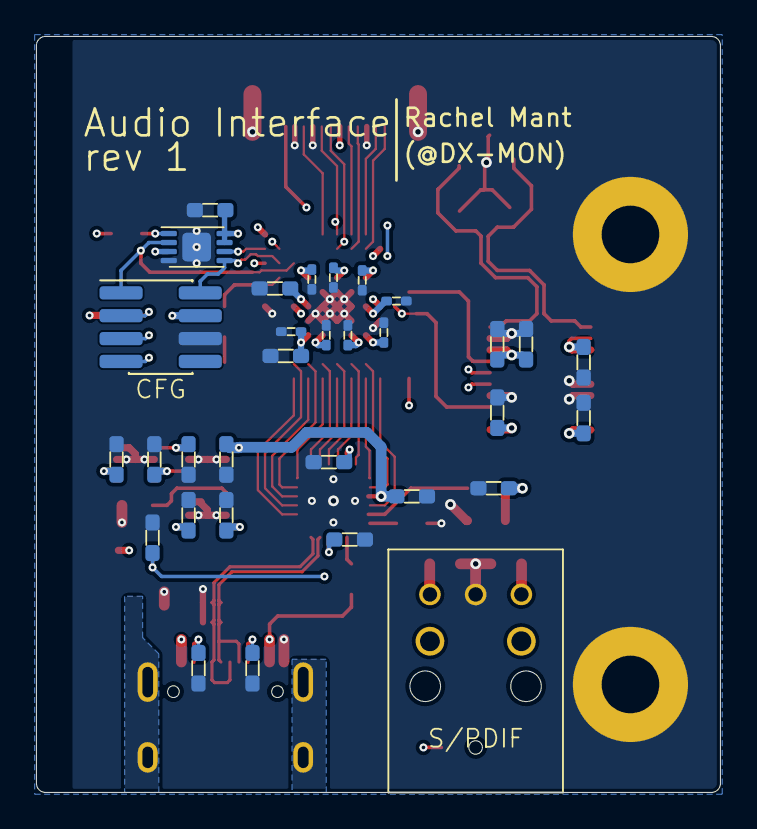
[picture p14: board AudioInterface.kicad_pcb from below]

Board: 4 copper layers, 38.0 x 42.0 mm, 60 parts (32 on the bottom side), 47 nets.

Other parts of the board:
G1: OSHW-Logo_5.7x6mm_SilkScreen
