dragonmux/HeadphoneAmp/hardware/SignalRouter/SignalRouter.kicad_pcb

## KiCad design hardware/SignalRouter/SignalRouter.kicad_pcb (2022-03-04)

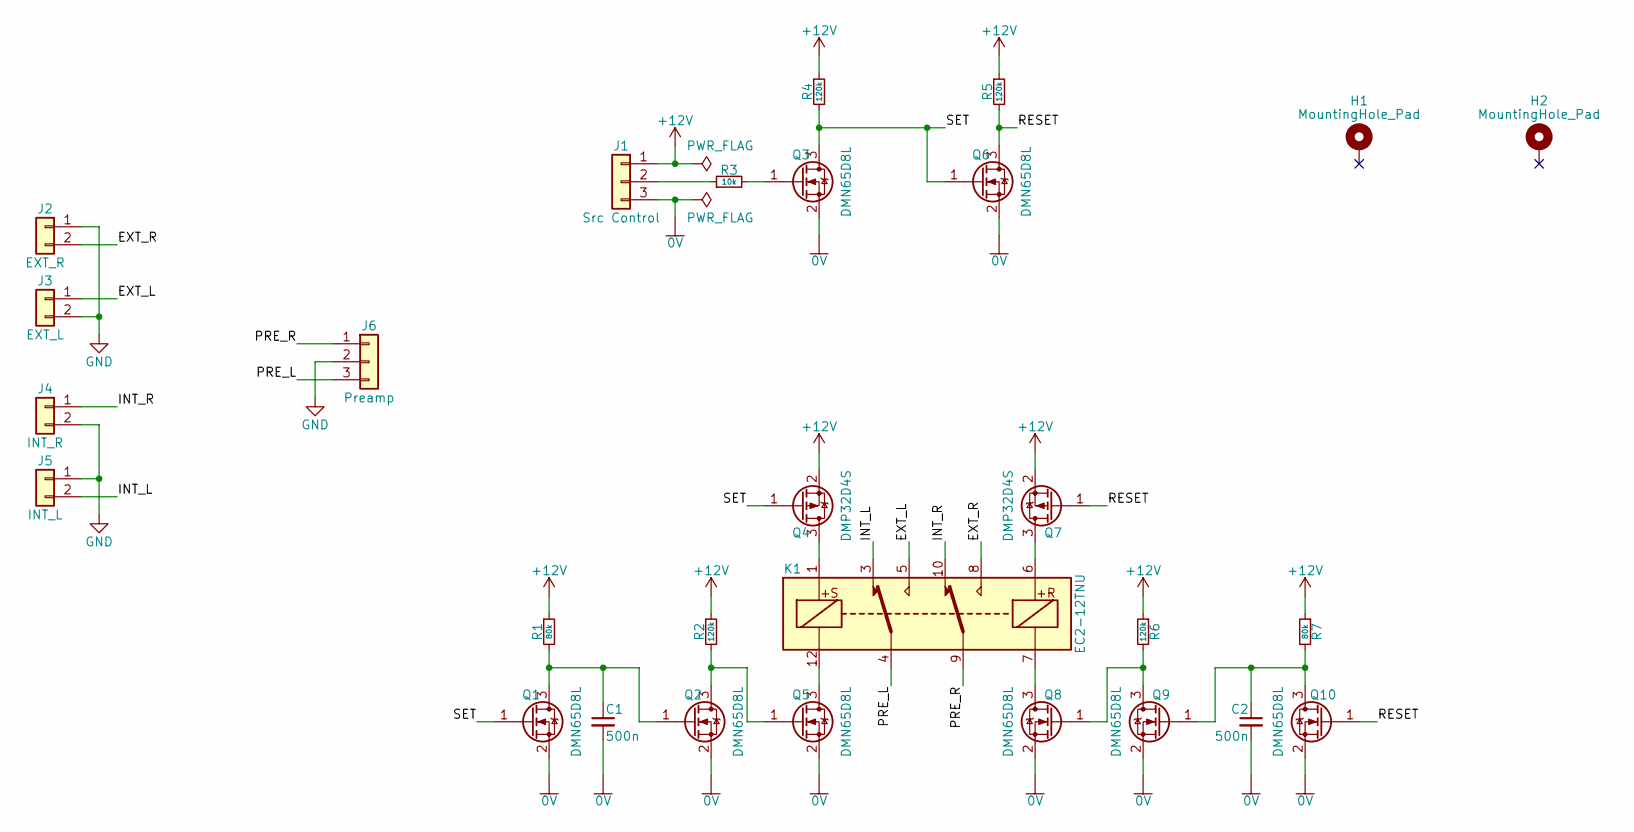
[picture p15: schematic SignalRouter.kicad_sch]

Parts:
C1, C2: 500n; C0603; MPN 0603B474K250CT
H1, H2: MountingHole_Pad; MountingHole_3.2mm_M3_Pad
J1: Src Control; PinHeader_1x03_P2.54mm_Vertical
J2: EXT_R; PinHeader_1x02_P2.54mm_Vertical
J3: EXT_L; PinHeader_1x02_P2.54mm_Vertical
J4: INT_R; PinHeader_1x02_P2.54mm_Vertical
J5: INT_L; PinHeader_1x02_P2.54mm_Vertical
J6: Preamp; PinHeader_1x03_P2.54mm_Vertical
K1: EC2-12TNU; Relay_DPDT_Kemet_EC2_DoubleCoil; MPN EC2-12TNU
Q1, Q2, Q3, Q5, Q6, Q8, Q9, Q10: DMN65D8L; SOT-23; MPN DMN65D8L-7
Q4, Q7: DMP32D4S; SOT-23; MPN DMP32D4S-7
R1, R7: 80k; R0603; MPN CRCW060380K6FKEA
R2, R4, R5, R6: 120k; R0603; MPN CRCW0603120KFKEA
R3: 10k; R0603; MPN CRCW060310K0FKEA

Connections:
0V: C1.2, C2.2, J1.3, Q1.2 (S), Q2.2 (S), Q3.2 (S), Q5.2 (S), Q6.2 (S), Q8.2 (S), Q9.2 (S), Q10.2 (S)
+12V: J1.1, Q4.2 (S), Q7.2 (S), R1.1, R2.1, R4.1, R5.1, R6.1, R7.1
/EXT_L: J3.1, K1.5
/EXT_R: J2.2, K1.8
/INT_L: J5.2, K1.3
/INT_R: J4.1, K1.10
/PRE_L: J6.3, K1.4
/PRE_R: J6.1, K1.9
/RESET: Q6.3 (D), Q7.1 (G), Q10.1 (G), R5.2
/SET: Q1.1 (G), Q3.3 (D), Q4.1 (G), Q6.1 (G), R4.2
GND: J2.1, J3.2, J4.2, J5.1, J6.2
unnamed: C1.1, Q1.3 (D), Q2.1 (G), R1.2
unnamed: C2.1, Q9.1 (G), Q10.3 (D), R7.2
unnamed: J1.2, R3.1
unnamed: K1.1, Q4.3 (D)
unnamed: K1.6, Q7.3 (D)
unnamed: K1.7, Q8.3 (D)
unnamed: K1.12, Q5.3 (D)
unnamed: Q2.3 (D), Q5.1 (G), R2.2
unnamed: Q3.1 (G), R3.2
unnamed: Q8.1 (G), Q9.3 (D), R6.2

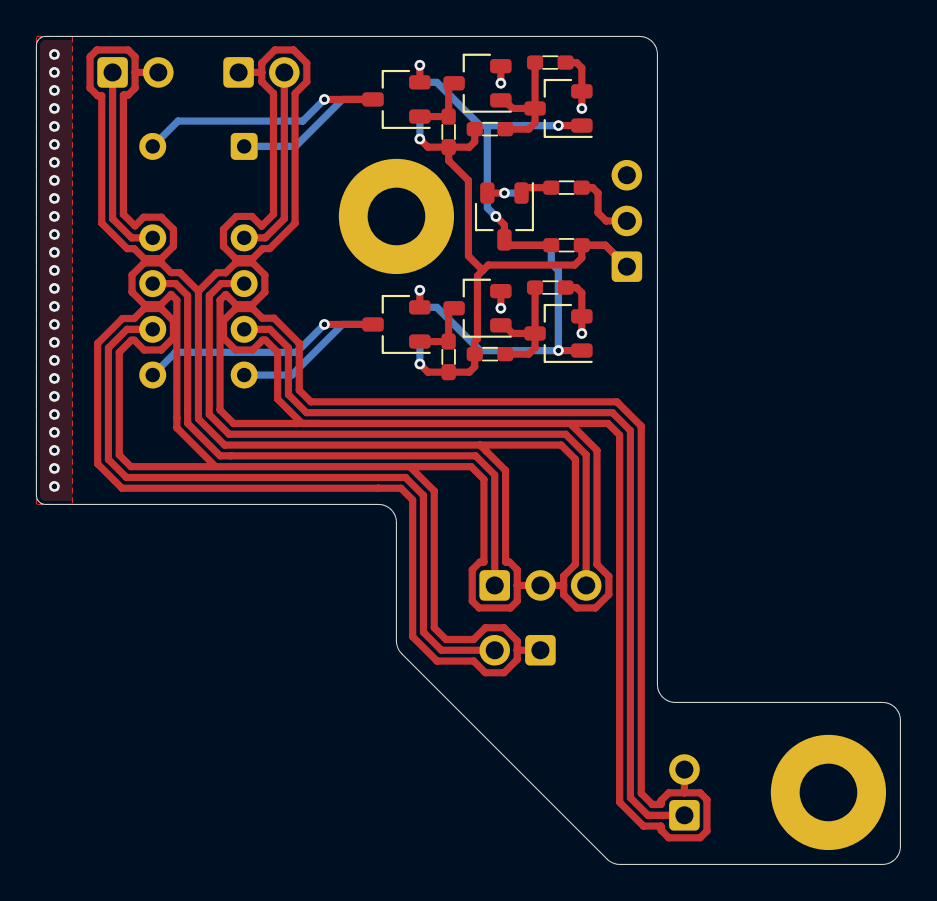
[picture p16: board SignalRouter.kicad_pcb from above]

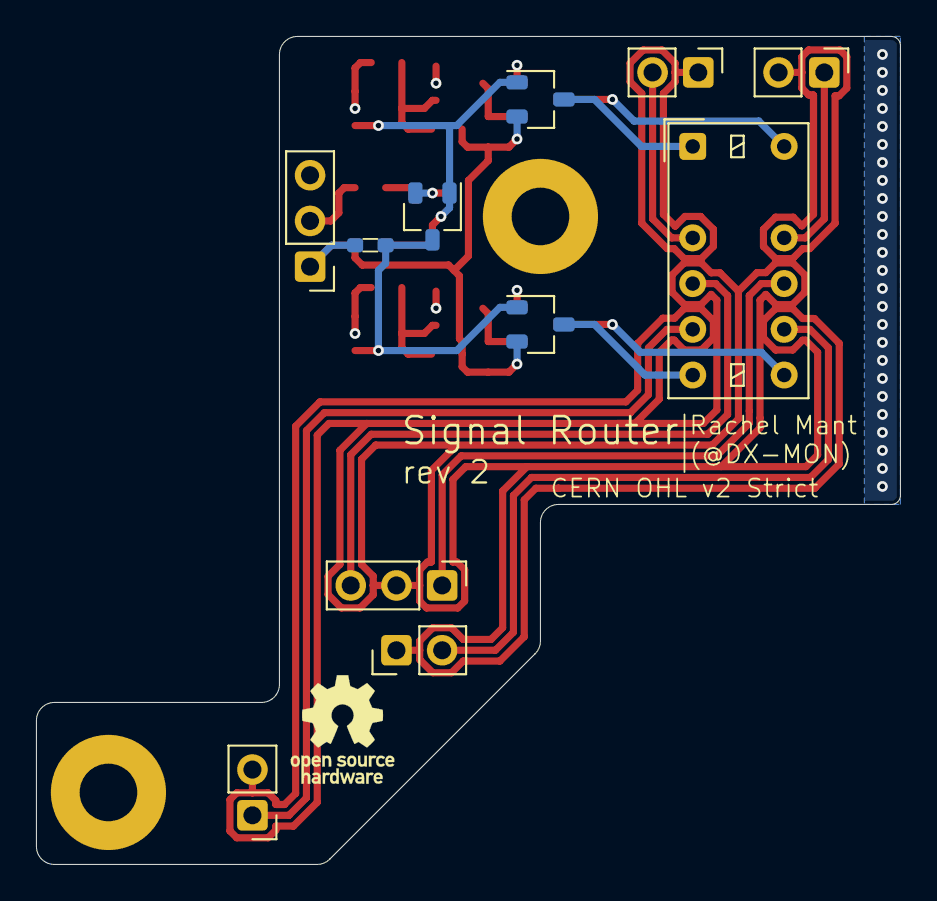
[picture p17: board SignalRouter.kicad_pcb from below]

Board: 4 copper layers, 48.0 x 46.0 mm, 28 parts (11 on the bottom side), 21 nets.
