dragonmux/HeadphoneAmp/(commit log)

2022-01-12 Created the schematics for the amplifier + DAC
    [DAC.kicad_sch, DigitalInterface.kicad_sch, HeadphoneAmp.kicad_sch, PowerSupplies.kicad_sch, Preamp+Amp.kicad_sch]
2022-01-12 Added the KiCad project file for the headphone amp + DAC board
2022-01-12 Added the KiCad PCB for the headphone amp + DAC board
    [HeadphoneAmp.kicad_pcb]
2022-01-12 Added the signal routing daughter board for the headphone amp
    [SignalRouter.kicad_pcb, SignalRouter.kicad_sch]
2022-01-12 Made the headphone amp + DAC board's refdes fabulous
    [HeadphoneAmp.kicad_pcb]
2022-01-12 Switched a couple of footprints, cleaning up the amp+dac board
    [HeadphoneAmp.kicad_sch]
2022-01-12 Added ignores for the gerber outputs
2022-01-12 Switched a pile of footprints over to our own versions
    [HeadphoneAmp.kicad_pcb, HeadphoneAmp.kicad_sch, PowerSupplies.kicad_sch]
2022-01-12 Added the circuitjs SPICE sim for the signal router board
2022-01-15 Cleanup in the base board
    [DigitalInterface.kicad_sch, HeadphoneAmp.kicad_pcb]
2022-01-15 Created schematics for an audio interface board for the DAC part of the project
    [AudioInterface.kicad_sch, ClockGen.kicad_sch, Power.kicad_sch, Processing.kicad_sch, USB.kicad_sch]
2022-01-15 Added a KiCad project and design rules for the audio interface
2022-01-15 Created the PCB layout for the audio interface board
    [AudioInterface.kicad_pcb]
2022-01-15 Improved the PSU enable/reset handling on the audio interface board
    [AudioInterface.kicad_pcb, Power.kicad_sch, Processing.kicad_sch]
2022-03-04 Completed a pile more work on the various boards that comprise the project
    [AudioInterface.kicad_pcb, AudioInterface.kicad_sch, ClockGen.kicad_sch, DigitalInterface.kicad_sch, HeadphoneAmp.kicad_pcb, HeadphoneAmp.kicad_sch, Power.kicad_sch, Processing.kicad_sch]
2022-03-05 gateware: usb: Added more of the descriptors required to configure the USB audio device
2022-03-05 gateware: usb: Added the proper alt-mode descriptors and audio streaming descriptor so we show up as a proper audio device
2022-03-06 gateware: usb: Implemented the power domain descriptor
2022-03-06 gateware: usb.control: Fixed a couple of mistakes in the AudioInterfaceHandler and StreamDeserializer
2022-03-07 gateware: usb.control.request: Stubbed in support for switching alt-modes in AudioRequestHandler
2022-03-07 gateware: usb: Fixed the power domain setup as it was wrong
2022-03-11 gateware: audio.i2s: Implemented a signal to request the next sample pair
2022-03-11 gateware: audio: Implemented the logic needed to get data from the USB endpoint to the sample FIFO
2022-03-12 gateware: audio: Fixed several bugs in the AudioStream module that caused the sample data to get corrupted on the way in
2022-03-12 gateware: sim.audio.i2s: Improvements to the I2S bus driver sim
2022-03-12 gateware: audio.i2s: Fixes to the I2S bus driver/initiator so it works correctly when driven with data from USB
2022-03-12 gateware: audio: Fixes to how the I2S bus driver is configured and driven by AudioStream
2022-04-10 gateware: sim.usb.control: Added a couple more receiveData assertions
2022-05-31 gateware: platform: Switched from passing lists of opts to Platform.build() to passing strings as the API changed
2022-09-25 gateware: sim.audio.stream: Updated the sim to reflect how the clock divider now works and the current gateware layout
2022-10-01 gateware: audio.i2s: Added a transition from run back to idle when the number of sample bits is reset to 0 or the clock divider reset to 0
2022-10-01 gateware: sim.audio.i2s: Cleaned up the gateware to run through the sample bits in reverse order directly, simplifying the cases for the last two bits
2022-10-01 gateware: sim.audio.i2s: Manually lift the sample bit count down to an addition to fix the timings
2023-03-19 gateware: Switched the gateware over to Torii HDL + Sol USB + usb-construct
2023-03-19 gateware: Switched the gateware simulations over to Torii HDL + Sol USB + usb-construct
2023-10-16 gateware: sim.framework: Dropped the dependency on Arachne as an intermdiate step
2023-10-16 gateware: cli: Switched from the old Arachne-based simulation framework to using unittest
2023-10-16 gateware: sim: Removed the old simulation framework now it's not used any more
2023-10-24 gateware: sim.audio.spdif: Implemented generation of the sample bit patterns for the sim
2023-10-24 gateware: audio.spdif: Reworked the subframe bit timing logic to take into account bit jitter so we don't enter a SYNC state too early or miss one entirely with a short timer reset
2023-10-24 gateware: audio.spdif: Began implementing 'Y' sync
    This implementation works but still needs bit timing validation done as it only detects when the timer would be exceeded, not if the transition happened too soon
2023-10-24 gateware: audio.spdif: Began implementing 'X' sync
    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
2023-10-25 gateware: audio.spdif: Implemented a signal for determining if the end of a sync is a block start, and fixed the frame begin signal
2023-10-25 gateware: audio.spdif: Fixed the subframe timing handler not incrementing the frame count at the end of each frame
2023-10-27 gateware: audio.spdif: Added a state and signals for initiating transfer from the block handler FIFOs to the I²S sample FIFO
2023-10-27 gateware: audio.spdif: Removed the unused frameBegin signal and updated the simulation to instead check blockEnd behaves properly
2023-10-27 gateware: audio.spdif: Corrected the sample validity check and control bits indexing
2023-10-27 gateware: audio.spdif: Added a couple more valid sample rate combinations to the block handler
2023-10-27 gateware: audio.spdif: Implemented decoding of the channel A type (left/right sample data)
2023-10-27 gateware: audio.spdif: Implemented the top-level sample output interface
2023-10-27 gateware: audio.spdif: Exposed the bit depth and sample rate information out through to the top level
2023-10-27 gateware: audio.spdif: Fixed all the bit values in the switch-case's being backwards
2023-10-27 gateware: audio.spdif: Fixed a couple of mistakes that had the data transfer logic broken
2023-10-27 gateware: audio.spdif: Switched the BlockHandler FIFOs over to SyncFIFOBuffered so they output data in the correct cycle
2023-10-27 gateware: sim.audio.spdif: Implemented a set of assertions to check that the block handler works correctly in the positive case
