dragonmux/HeadphoneAmp/(notices)

Notices in the files:
hardware/SignalRouter/SignalRouter.kicad_pcb:
CERN OHL v2 Strict
hardware/AudioInterface/AudioInterface.kicad_pcb:
CERN OHL
